electrolama/mcore-h616-breakout/README.md

# mcore-h616-breakout

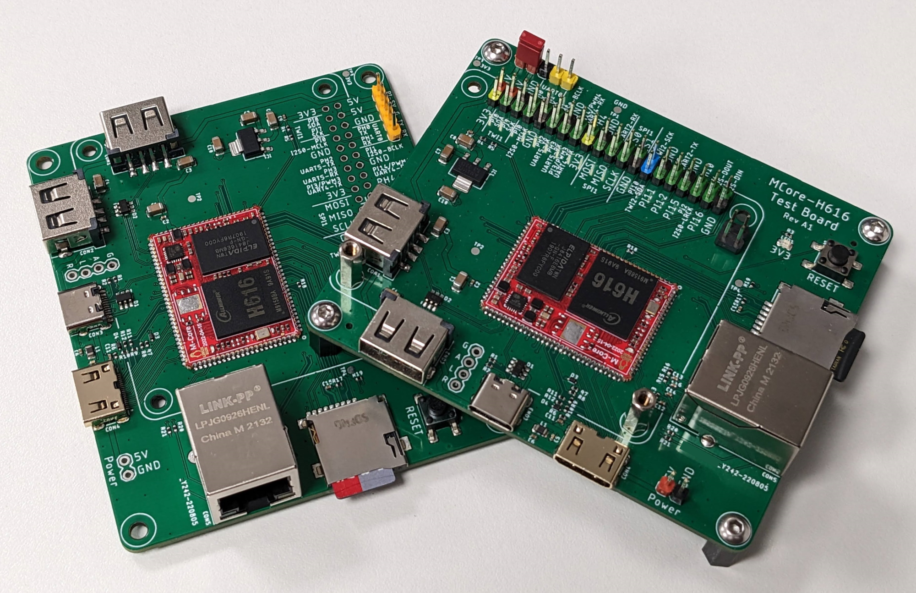
[picture p1: mcore-h616-test-board.jpg]
assembled mcore-h616-breakout boards


A breakout for the [Mango Pi MCore-H616](https://mangopi.org/mcoreh616) module.
