electrolama/mcore-h616-breakout/hardware/Revision A1/prod/mcore-h616-breakout-RevA1-PCBA.png

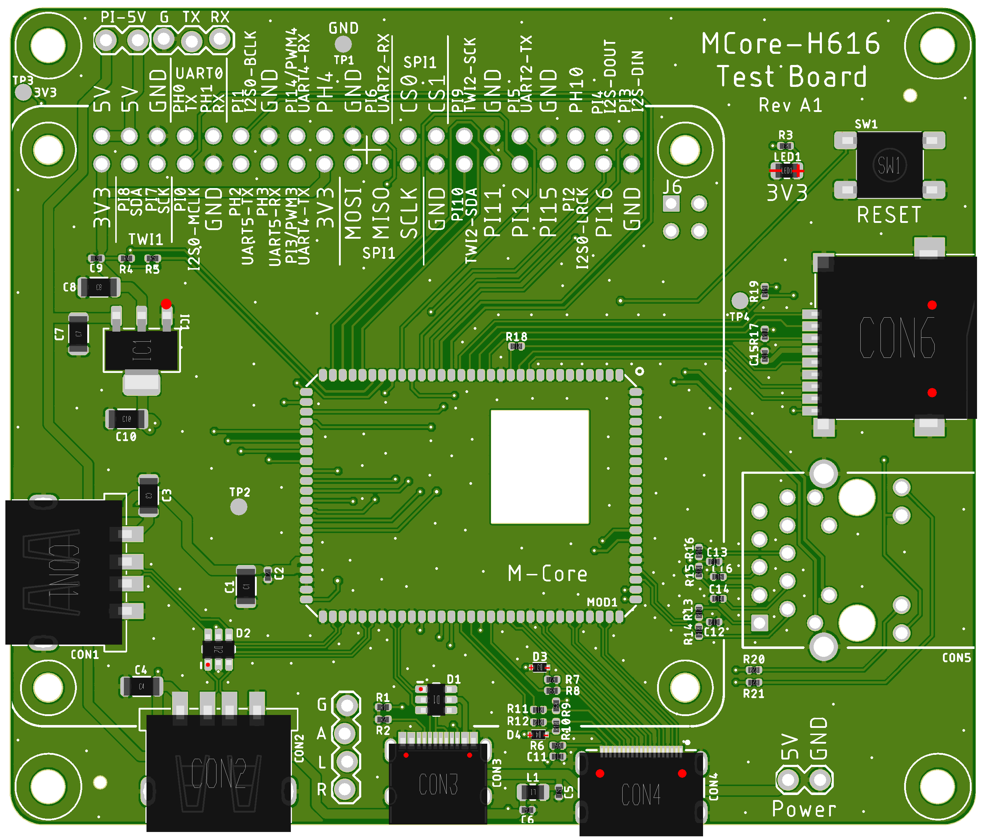
hardware/Revision A1/prod/mcore-h616-breakout-RevA1-PCBA.png
