electrolama/mcore-h616-breakout/reference/616core-back.png

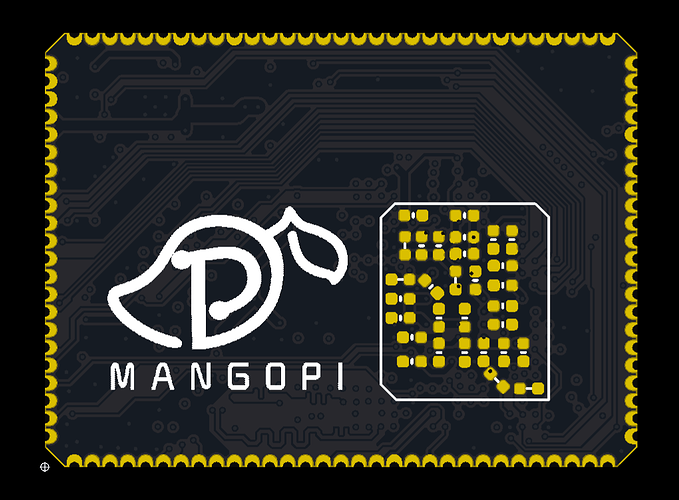
reference/616core-back.png
