electrolama/mcore-h616-breakout/reference/616core-front.png

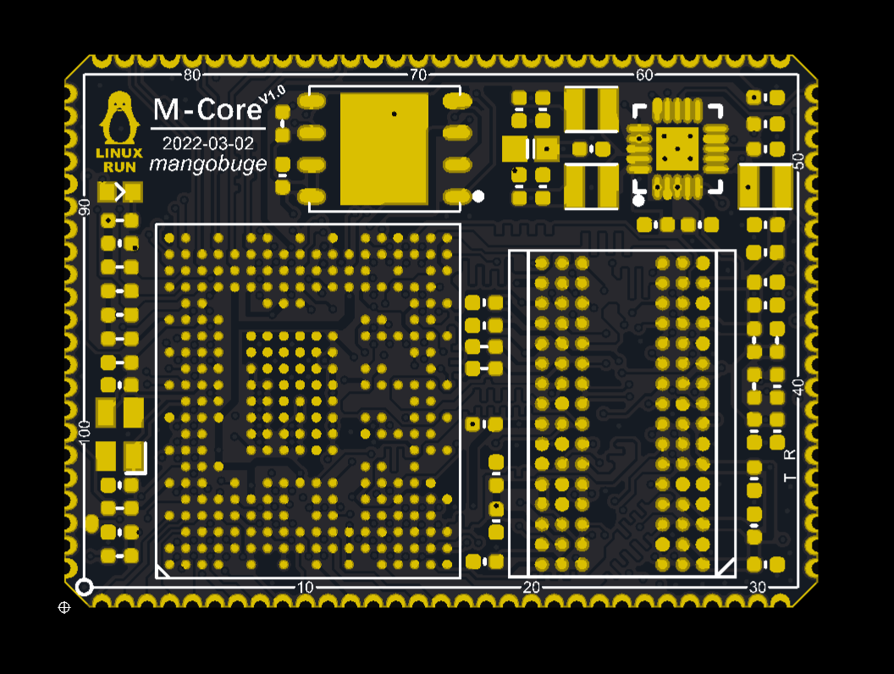
reference/616core-front.png
