electrolama/mcore-h616-breakout/reference/android-partitions.png

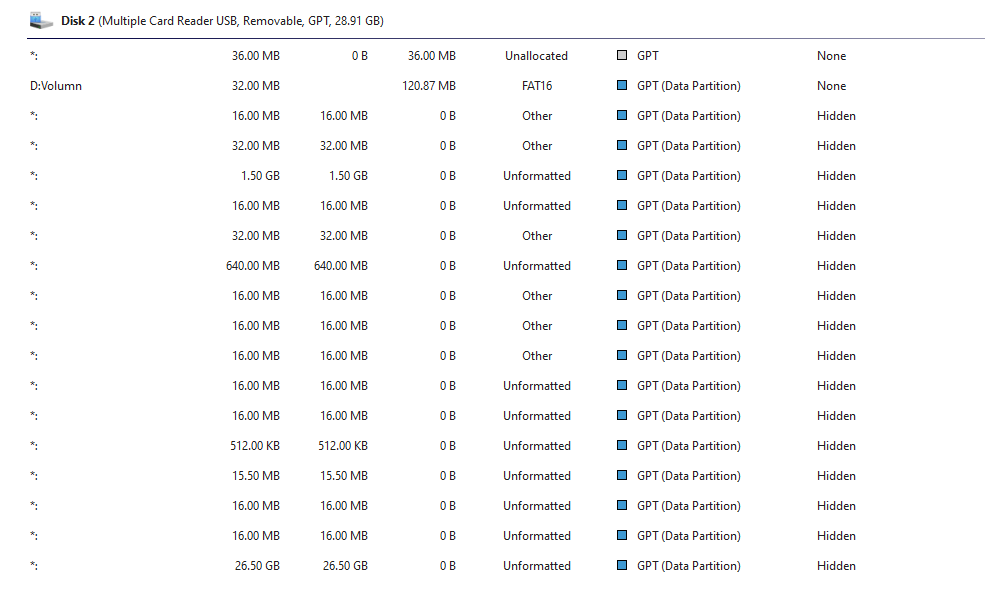
reference/android-partitions.png
