electrolama/mcore-h616-breakout/reference/android-phoenixcard.png

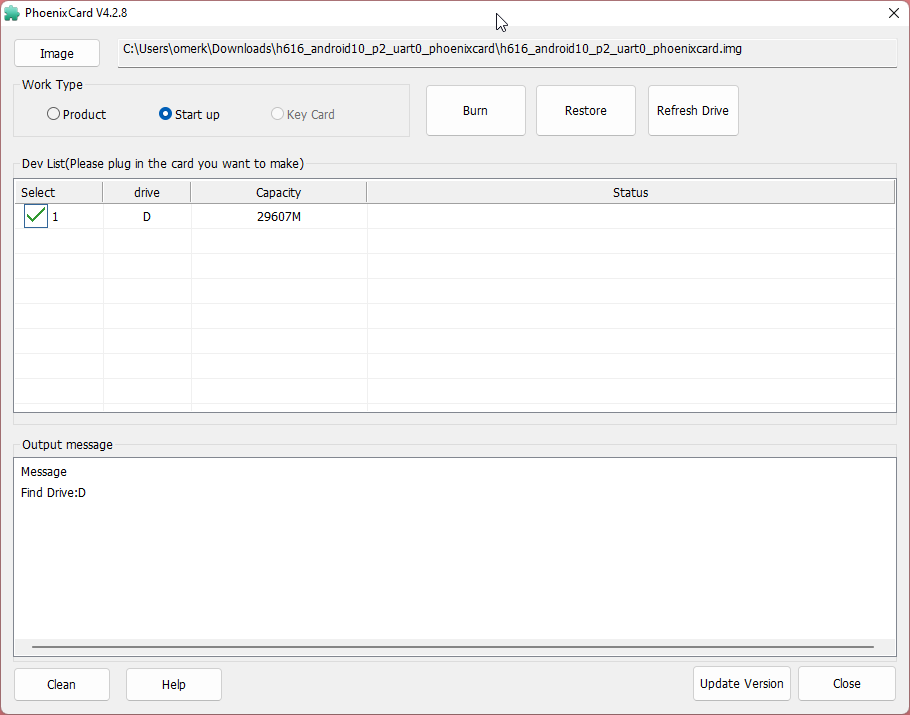
reference/android-phoenixcard.png
