electrolama/mcore-h616-breakout/reference/MQ-Quad-rpi40-pins.png

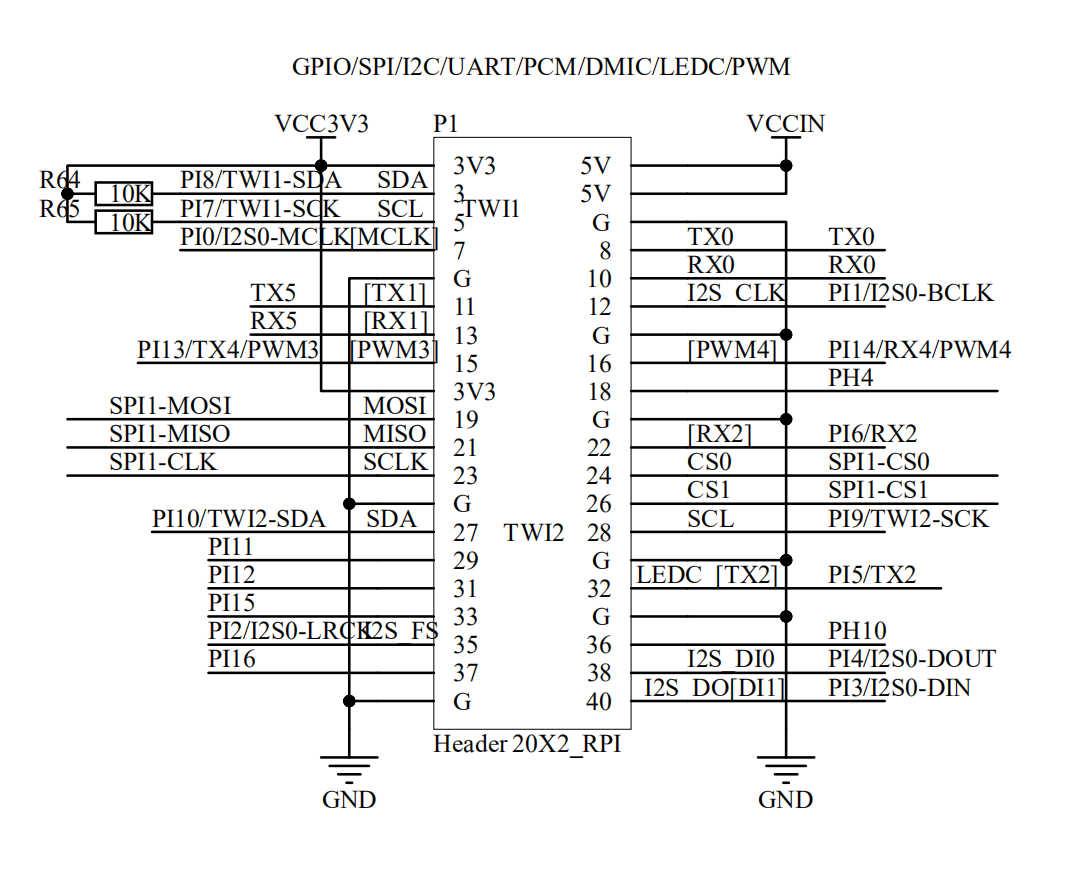
reference/MQ-Quad-rpi40-pins.png
