electrolama/mcore-h616-breakout/hardware/Revision A1/prod/mcore-h616-breakout-RevA1-BOM.xlsx

Comment | Designator | Footprint | JLCPCB Part # | Manufacturer | MPN | Qty
 | J3, J5 | 1X02_LOCK |  |  |  | 2
 | J2 | 1X03_LOCK |  |  |  | 1
 | J1 | 1X04_LOCK |  |  |  | 1
 | J6 | CON_2.54MM_TH_2X2 |  |  |  | 1
 | J4 | CON_2.54MM_TH_2X20 |  |  |  | 1
 | LED1 | _PKG_LED_0805 | C2296 |  |  | 1
 | CON1, CON2 | JING_912-121A2023S10100 | C42428 |  |  | 2
 | CON3 | USBC_C-31-M-12 | C165948 |  |  | 1
 | MOD1 | MCORE-H616_V1 |  |  |  | 1
100 | R3, R8, R11, R12, R18, R20, R21 | _PKG_R_0402 | C25076 |  |  | 7
100n | C2, C6, C9, C11, C12, C13, C14, C15, C16 | _PKG_C_0402 | C307331 |  |  | 9
10k | R4, R5, R17, R19 | _PKG_R_0402 | C25744 |  |  | 4
10n | C5 | _PKG_C_0402 | C15195 |  |  | 1
1k | R6 | _PKG_R_0402 | C11702 |  |  | 1
1k8 | R9, R10 | _PKG_R_0402 | C25871 |  |  | 2
27k 1% | R7 | _PKG_R_0402 | C25771 |  |  | 1
47u | C1, C3, C4, C7, C8, C10 | _PKG_C_1206 | C96123 |  |  | 6
49.9Ω | R13, R14, R15, R16 | _PKG_R_0402 | C25120 |  |  | 4
5k1 | R1, R2 | _PKG_R_0402 | C25905 |  |  | 2
C111196 - TF-15x15 | CON6 | TF/SHENZHEN-SPECIAL | C111196 |  |  | 1
C136421 - HDMI-519 | CON4 | 685119136923 | C136421 |  |  | 1
FB | L1 | _PKG_C_0805 | C75661 |  |  | 1
LD1117-3.3 | IC1 | _PKG_SOT223-4_TI-DCY4 | C6186 |  |  | 1
LPJG0926HENL | CON5 | LPJG0926HENL |  |  |  | 1
RB520S30T1G | D3, D4 | _PKG_SOD523 | C154821 |  |  | 2
SPNO | SW1 | GENERIC_SPNO_4P_6X6MM | C620316 |  |  | 1
SRV05-4-P-T7 | D1, D2 | SOT95P280X145-6N | C85364 |  |  | 2
