electrolama/mcore-h616-breakout/hardware/Revision A1/mcore-h616-breakout-RevA1-schematics.pdf

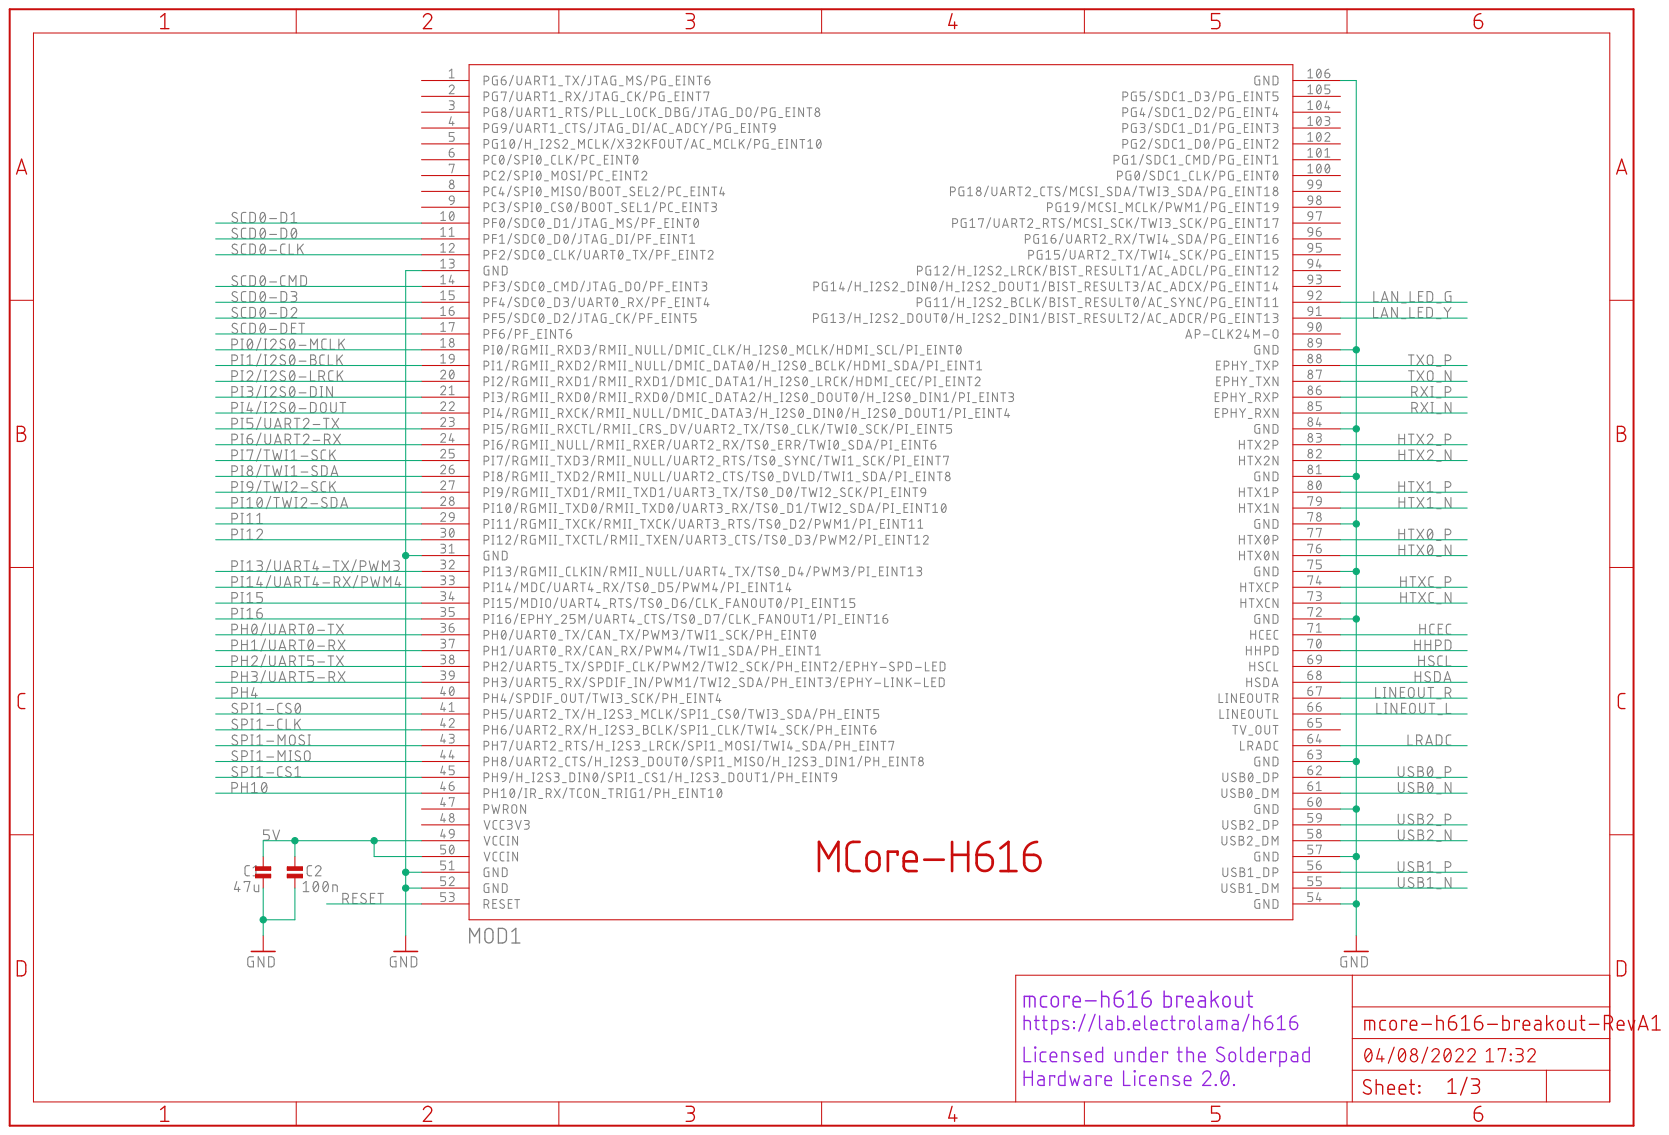
[picture p8: page 1]

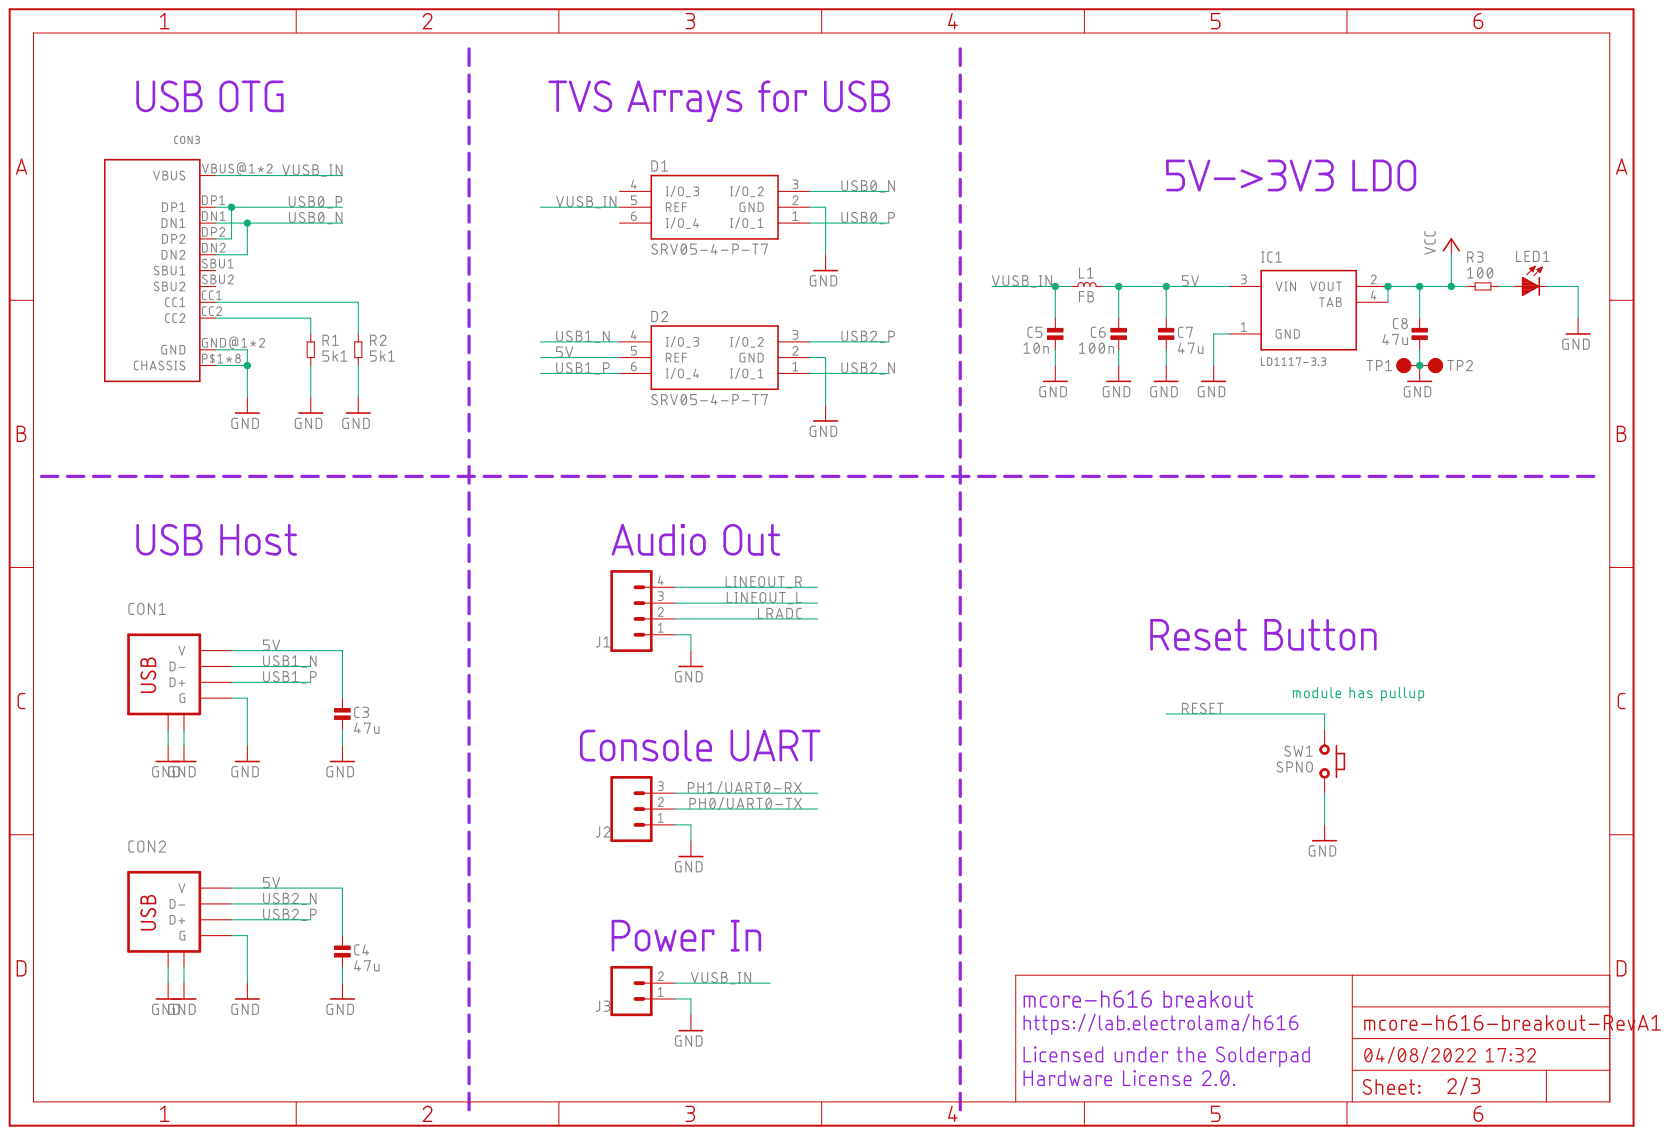
[picture p9: page 2]

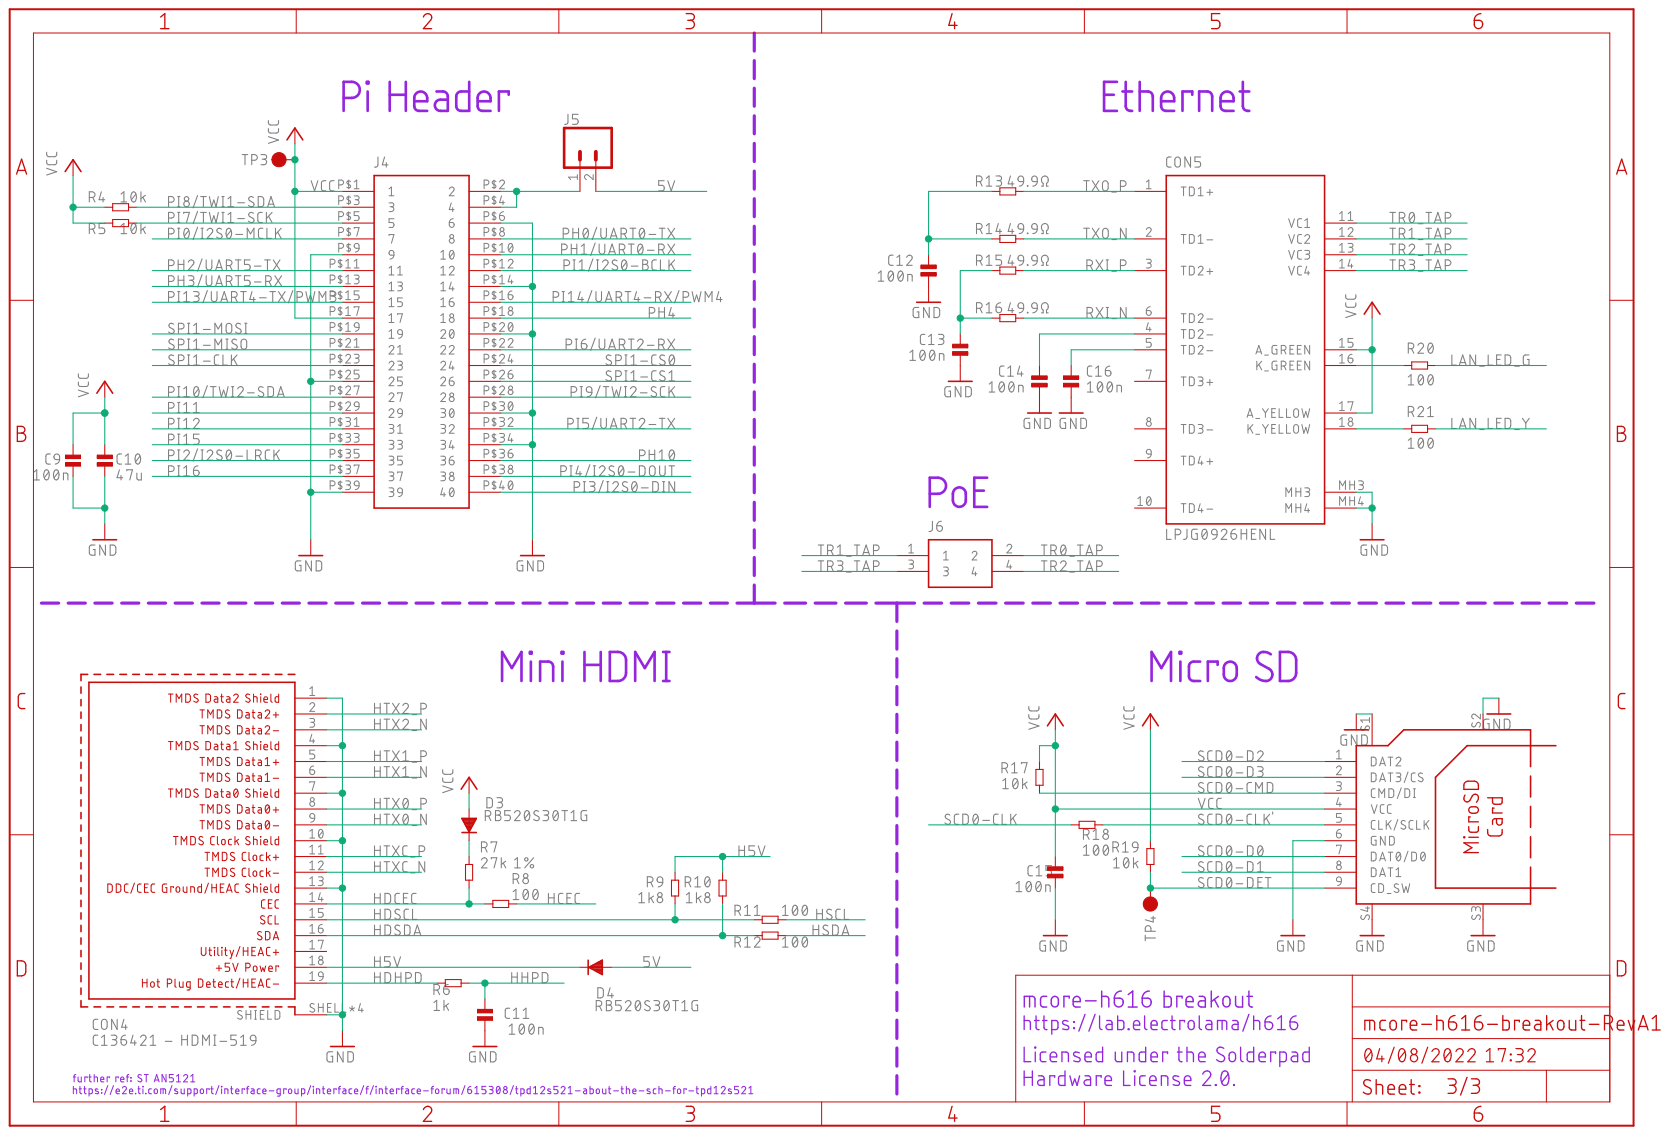
[picture p10: page 3]
