electrolama/mcore-h616-breakout/(list of files, drawings)

Other design files:
reference/616-demoboard/616-demo-PRJ.PrjPCB
reference/616-demoboard/D1-Periph.SchDoc
reference/616-demoboard/WIFI-BT.SchDoc
