electrolama/mcore-h616-breakout/hardware/Revision A1/mcore-h616-breakout-RevA1.brd

## EAGLE design hardware/Revision A1/mcore-h616-breakout-RevA1.brd (2022-08-04)

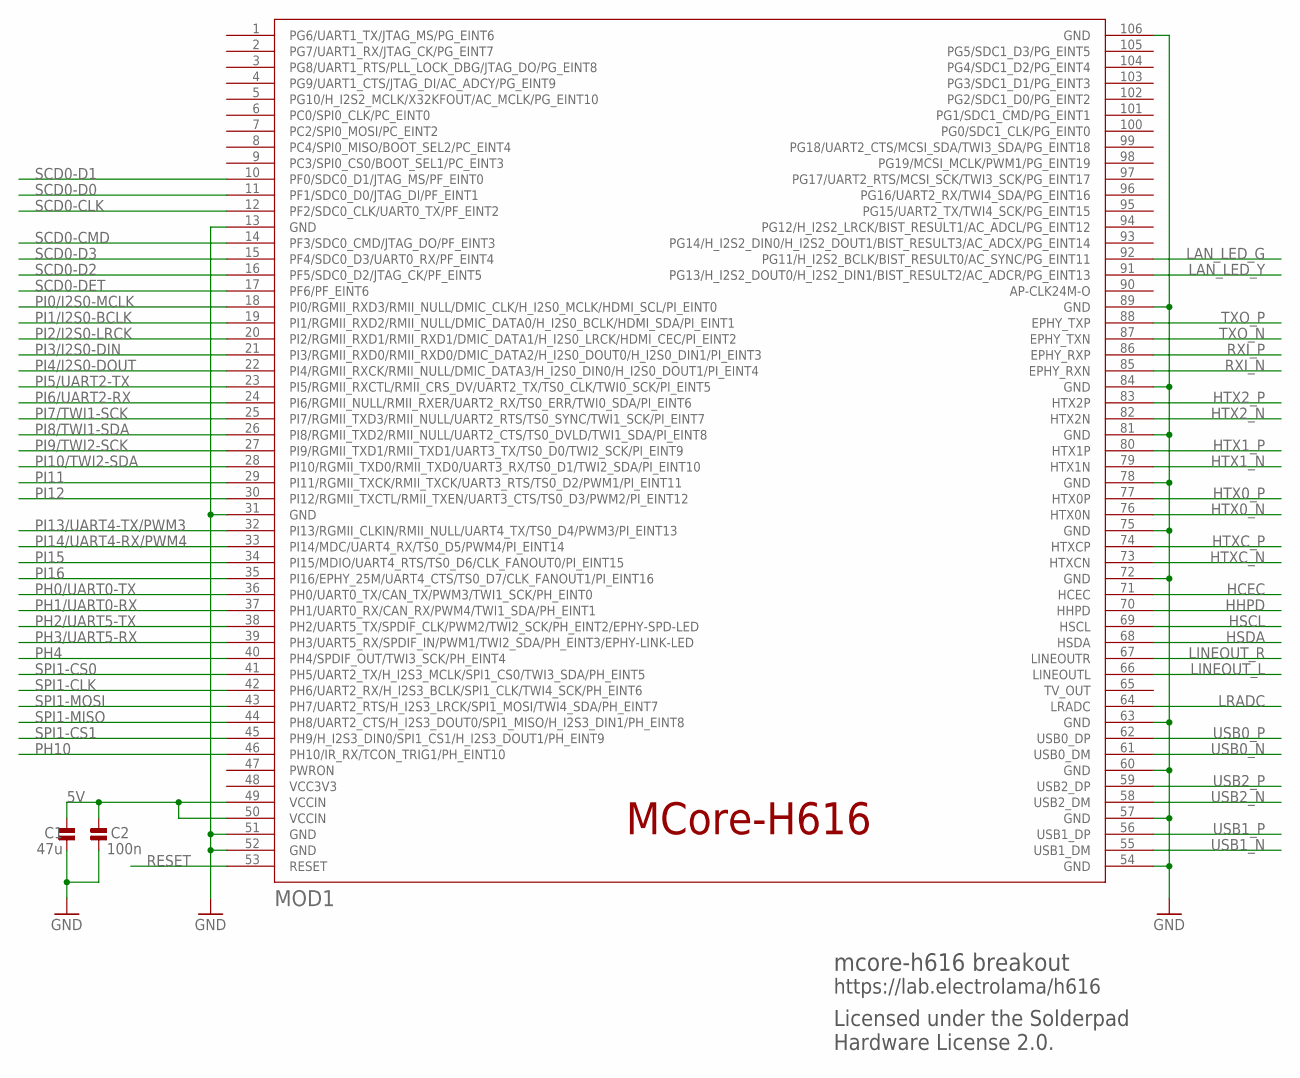
[picture p11: schematic mcore-h616-breakout-RevA1.sch, sheet 1]

Parts:
C1: 47u; _PKG_C_1206; JLCASSY C96123
C2: 100n; _PKG_C_0402; JLCASSY C307331
MOD1: WIDORA_MCORE-H616_V1; MCORE-H616_V1

Connections:
5V: C1.2, C2.2, MOD1.49 (VCCIN), MOD1.50 (VCCIN); also elsewhere on the board
GND: C1.1, C2.1, MOD1.13 (GND), MOD1.31 (GND), MOD1.51 (GND), MOD1.52 (GND), MOD1.54 (GND), MOD1.57 (GND), MOD1.60 (GND), MOD1.63 (GND), MOD1.72 (GND), MOD1.75 (GND), MOD1.78 (GND), MOD1.81 (GND), MOD1.84 (GND), MOD1.89 (GND), MOD1.106 (GND); also elsewhere on the board
HCEC: MOD1.71 (HCEC); also elsewhere on the board
HHPD: MOD1.70 (HHPD); also elsewhere on the board
HSCL: MOD1.69 (HSCL); also elsewhere on the board
HSDA: MOD1.68 (HSDA); also elsewhere on the board
HTX0_N: MOD1.76 (HTX0N); also elsewhere on the board
HTX0_P: MOD1.77 (HTX0P); also elsewhere on the board
HTX1_N: MOD1.79 (HTX1N); also elsewhere on the board
HTX1_P: MOD1.80 (HTX1P); also elsewhere on the board
HTX2_N: MOD1.82 (HTX2N); also elsewhere on the board
HTX2_P: MOD1.83 (HTX2P); also elsewhere on the board
HTXC_N: MOD1.73 (HTXCN); also elsewhere on the board
HTXC_P: MOD1.74 (HTXCP); also elsewhere on the board
LAN_LED_G: MOD1.92 (PG11/H_I2S2_BCLK/BIST_RESULT0/AC_SYNC/P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); also elsewhere on the board
LAN_LED_Y: MOD1.91 (PG13/H_I2S2_DOUT0/H_I2S2_DIN1/BIST_RESU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); also elsewhere on the board
LINEOUT_L: MOD1.66 (LINEOUTL); also elsewhere on the board
LINEOUT_R: MOD1.67 (LINEOUTR); also elsewhere on the board
LRADC: MOD1.64 (LRADC); also elsewhere on the board
PH0/UART0-TX: MOD1.36 (PH0/UART0_TX/CAN_TX/PWM3/TWI1_SCK/PH_EI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); also elsewhere on the board
PH1/UART0-RX: MOD1.37 (PH1/UART0_RX/CAN_RX/PWM4/TWI1_SDA/PH_EI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); also elsewhere on the board
PH2/UART5-TX: MOD1.38 (PH2/UART5_TX/SPDIF_CLK/PWM2/TWI2_SCK/PH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); also elsewhere on the board
PH3/UART5-RX: MOD1.39 (PH3/UART5_RX/SPDIF_IN/PWM1/TWI2_SDA/PH_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); also elsewhere on the board
PH4: MOD1.40 (PH4/SPDIF_OUT/TWI3_SCK/PH_EINT4); also elsewhere on the board
PH10: MOD1.46 (PH10/IR_RX/TCON_TRIG1/PH_EINT10); also elsewhere on the board
PI0/I2S0-MCLK: MOD1.18 (PI0/RGMII_RXD3/RMII_NULL/DMIC_CLK/H_I2S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); also elsewhere on the board
PI1/I2S0-BCLK: MOD1.19 (PI1/RGMII_RXD2/RMII_NULL/DMIC_DATA0/H_I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); also elsewhere on the board
PI2/I2S0-LRCK: MOD1.20 (PI2/RGMII_RXD1/RMII_RXD1/DMIC_DATA1/H_I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); also elsewhere on the board
PI3/I2S0-DIN: MOD1.21 (PI3/RGMII_RXD0/RMII_RXD0/DMIC_DATA2/H_I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); also elsewhere on the board
PI4/I2S0-DOUT: MOD1.22 (PI4/RGMII_RXCK/RMII_NULL/DMIC_DATA3/H_I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); also elsewhere on the board
PI5/UART2-TX: MOD1.23 (PI5/RGMII_RXCTL/RMII_CRS_DV/UART2_TX/TS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); also elsewhere on the board
PI6/UART2-RX: MOD1.24 (PI6/RGMII_NULL/RMII_RXER/UART2_RX/TS0_E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); also elsewhere on the board
PI7/TWI1-SCK: MOD1.25 (PI7/RGMII_TXD3/RMII_NULL/UART2_RTS/TS0_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); also elsewhere on the board
PI8/TWI1-SDA: MOD1.26 (PI8/RGMII_TXD2/RMII_NULL/UART2_CTS/TS0_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); also elsewhere on the board
PI9/TWI2-SCK: MOD1.27 (PI9/RGMII_TXD1/RMII_TXD1/UART3_TX/TS0_D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); also elsewhere on the board
PI10/TWI2-SDA: MOD1.28 (PI10/RGMII_TXD0/RMII_TXD0/UART3_RX/TS0_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); also elsewhere on the board
PI11: MOD1.29 (PI11/RGMII_TXCK/RMII_TXCK/UART3_RTS/TS0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); also elsewhere on the board
PI12: MOD1.30 (PI12/RGMII_TXCTL/RMII_TXEN/UART3_CTS/TS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); also elsewhere on the board
PI13/UART4-TX/PWM3: MOD1.32 (PI13/RGMII_CLKIN/RMII_NULL/UART4_TX/TS0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); also elsewhere on the board
PI14/UART4-RX/PWM4: MOD1.33 (PI14/MDC/UART4_RX/TS0_D5/PWM4/PI_EINT14); also elsewhere on the board
PI15: MOD1.34 (PI15/MDIO/UART4_RTS/TS0_D6/CLK_FANOUT0/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); also elsewhere on the board
PI16: MOD1.35 (PI16/EPHY_25M/UART4_CTS/TS0_D7/CLK_FANO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); also elsewhere on the board
RESET: MOD1.53 (RESET); also elsewhere on the board
RXI_N: MOD1.85 (EPHY_RXN); also elsewhere on the board
RXI_P: MOD1.86 (EPHY_RXP); also elsewhere on the board
SCD0-CLK: MOD1.12 (PF2/SDC0_CLK/UART0_TX/PF_EINT2); also elsewhere on the board
SCD0-CMD: MOD1.14 (PF3/SDC0_CMD/JTAG_DO/PF_EINT3); also elsewhere on the board
SCD0-D0: MOD1.11 (PF1/SDC0_D0/JTAG_DI/PF_EINT1); also elsewhere on the board
SCD0-D1: MOD1.10 (PF0/SDC0_D1/JTAG_MS/PF_EINT0); also elsewhere on the board
SCD0-D2: MOD1.16 (PF5/SDC0_D2/JTAG_CK/PF_EINT5); also elsewhere on the board
SCD0-D3: MOD1.15 (PF4/SDC0_D3/UART0_RX/PF_EINT4); also elsewhere on the board
SCD0-DET: MOD1.17 (PF6/PF_EINT6); also elsewhere on the board
SPI1-CLK: MOD1.42 (PH6/UART2_RX/H_I2S3_BCLK/SPI1_CLK/TWI4_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); also elsewhere on the board
SPI1-CS0: MOD1.41 (PH5/UART2_TX/H_I2S3_MCLK/SPI1_CS0/TWI3_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); also elsewhere on the board
SPI1-CS1: MOD1.45 (PH9/H_I2S3_DIN0/SPI1_CS1/H_I2S3_DOUT1/P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); also elsewhere on the board
SPI1-MISO: MOD1.44 (PH8/UART2_CTS/H_I2S3_DOUT0/SPI1_MISO/H_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); also elsewhere on the board
SPI1-MOSI: MOD1.43 (PH7/UART2_RTS/H_I2S3_LRCK/SPI1_MOSI/TWI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); also elsewhere on the board
TXO_N: MOD1.87 (EPHY_TXN); also elsewhere on the board
TXO_P: MOD1.88 (EPHY_TXP); also elsewhere on the board
USB0_N: MOD1.61 (USB0_DM); also elsewhere on the board
USB0_P: MOD1.62 (USB0_DP); also elsewhere on the board
USB1_N: MOD1.55 (USB1_DM); also elsewhere on the board
USB1_P: MOD1.56 (USB1_DP); also elsewhere on the board
USB2_N: MOD1.58 (USB2_DM); also elsewhere on the board
USB2_P: MOD1.59 (USB2_DP); also elsewhere on the board

Notes on the sheet:
mcore-h616 breakout
https://lab.electrolama/h616
Licensed under the Solderpad Hardware License 2.0.

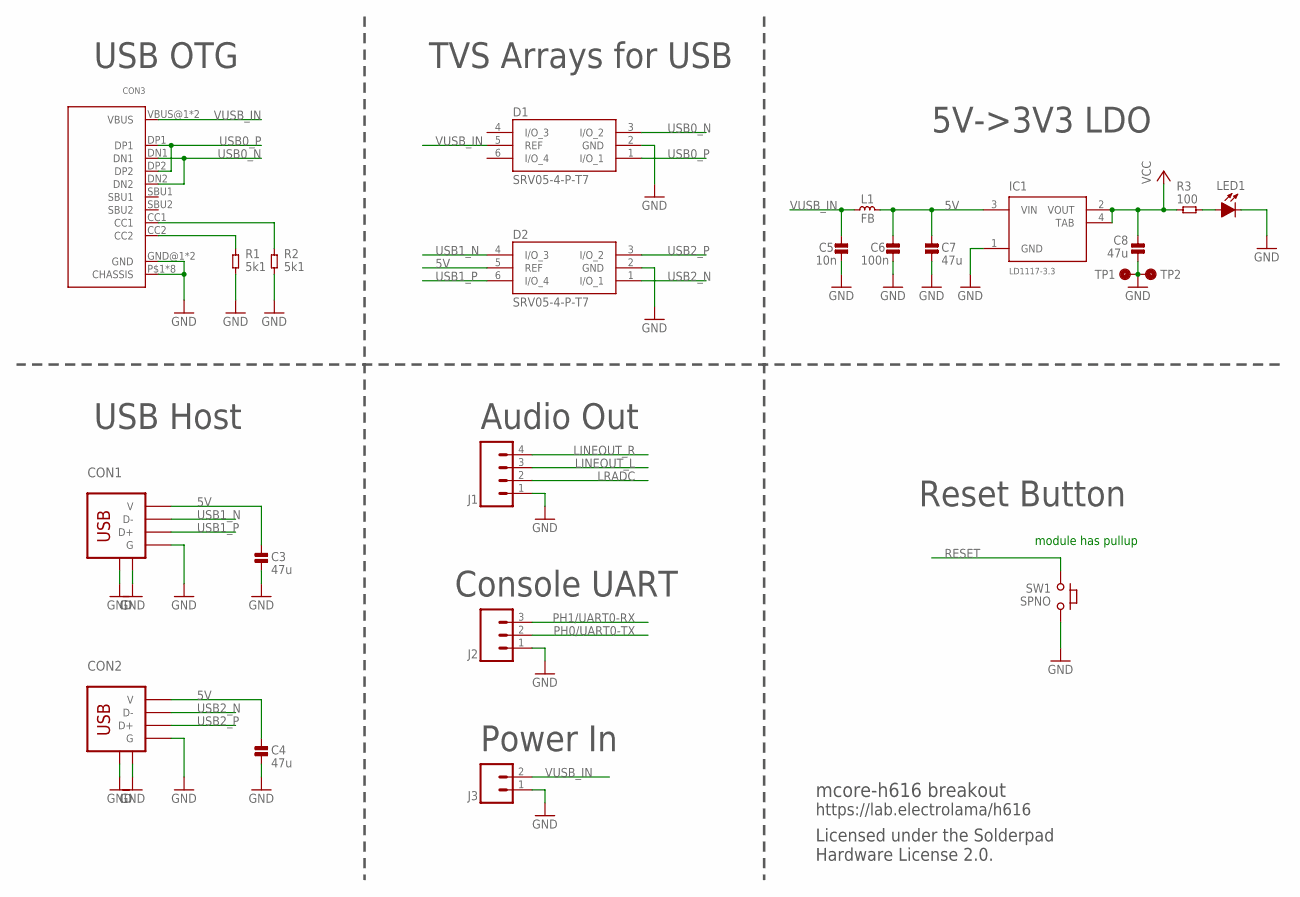
[picture p12: schematic mcore-h616-breakout-RevA1.sch, sheet 2]

Parts:
C3, C4, C7, C8: 47u; _PKG_C_1206; JLCASSY C96123
C5: 10n; _PKG_C_0402; JLCASSY C15195
C6: 100n; _PKG_C_0402; JLCASSY C307331
CON1, CON2: USB-A-FEMALE-JING-912-121A2023S10100; JING_912-121A2023S10100; JLCASSY C42428
CON3: USBC_USB-C-12; USBC_C-31-M-12; JLCASSY C165948
D1, D2: SRV05-4-P-T7; SOT95P280X145-6N; JLCASSY C85364
IC1: LD1117-3.3; _PKG_SOT223-4_TI-DCY4; JLCASSY C6186
J1: CONN_04LOCK; 1X04_LOCK
J2: CONN_03LOCK; 1X03_LOCK
J3: CONN_02LOCK; 1X02_LOCK
L1: FB; _PKG_C_0805; JLCASSY C75661
LED1: LED-0805; _PKG_LED_0805; JLCASSY C2296
R1, R2: 5k1; _PKG_R_0402; JLCASSY C25905
R3: 100; _PKG_R_0402; JLCASSY C25076
SW1: SPNO; GENERIC_SPNO_4P_6X6MM; JLCASSY C620316
TP1, TP2: TP; TP_DOT_1.5X1.5MM

Connections:
5V: C3.2, C4.2, C6.2, C7.2, CON1.VBUS (V), CON2.VBUS (V), D2.5 (REF), IC1.3 (VIN), L1.2; also elsewhere on the board
GND: C3.1, C4.1, C5.1, C6.1, C7.1, C8.1, CON1.GND (G), CON1.P$5 (SHIELD1), CON1.P$6 (SHIELD2), CON2.GND (G), CON2.P$5 (SHIELD1), CON2.P$6 (SHIELD2), CON3.GND@1 (GND), CON3.GND@2 (GND), CON3.P$1 (CHASSIS), CON3.P$2 (CHASSIS), CON3.P$3 (CHASSIS), CON3.P$4 (CHASSIS), CON3.P$5 (CHASSIS), CON3.P$6 (CHASSIS), CON3.P$7 (CHASSIS), CON3.P$8 (CHASSIS), D1.2 (GND), D2.2 (GND), IC1.1 (GND), J1.1, J2.1, J3.1, LED1.C, R1.1, R2.1, SW1.P$3 (2), SW1.P$4 (2), TP1.TP, TP2.TP; also elsewhere on the board
LINEOUT_L: J1.3; also elsewhere on the board
LINEOUT_R: J1.4; also elsewhere on the board
LRADC: J1.2; also elsewhere on the board
unnamed: LED1.A, R3.1
unnamed: CON3.CC1, R2.2
unnamed: CON3.CC2, R1.2
PH0/UART0-TX: J2.2; also elsewhere on the board
PH1/UART0-RX: J2.3; also elsewhere on the board
RESET: SW1.P$1 (1), SW1.P$2 (1); also elsewhere on the board
USB0_N: CON3.DN1, CON3.DN2, D1.3 (I/O_2); also elsewhere on the board
USB0_P: CON3.DP1, CON3.DP2, D1.1 (I/O_1); also elsewhere on the board
USB1_N: CON1.DM (D-), D2.4 (I/O_3); also elsewhere on the board
USB1_P: CON1.DP (D+), D2.6 (I/O_4); also elsewhere on the board
USB2_N: CON2.DM (D-), D2.1 (I/O_1); also elsewhere on the board
USB2_P: CON2.DP (D+), D2.3 (I/O_2); also elsewhere on the board
VCC: C8.2, IC1.2 (VOUT), IC1.4 (TAB), R3.2; also elsewhere on the board
VUSB_IN: C5.2, CON3.VBUS@1 (VBUS), CON3.VBUS@2 (VBUS), D1.5 (REF), J3.2, L1.1

Notes on the sheet:
module has pullup
USB OTG
TVS Arrays for USB
USB Host
Audio Out
Console UART
Power In
Reset Button
5V->3V3 LDO
mcore-h616 breakout
https://lab.electrolama/h616
Licensed under the Solderpad Hardware License 2.0.

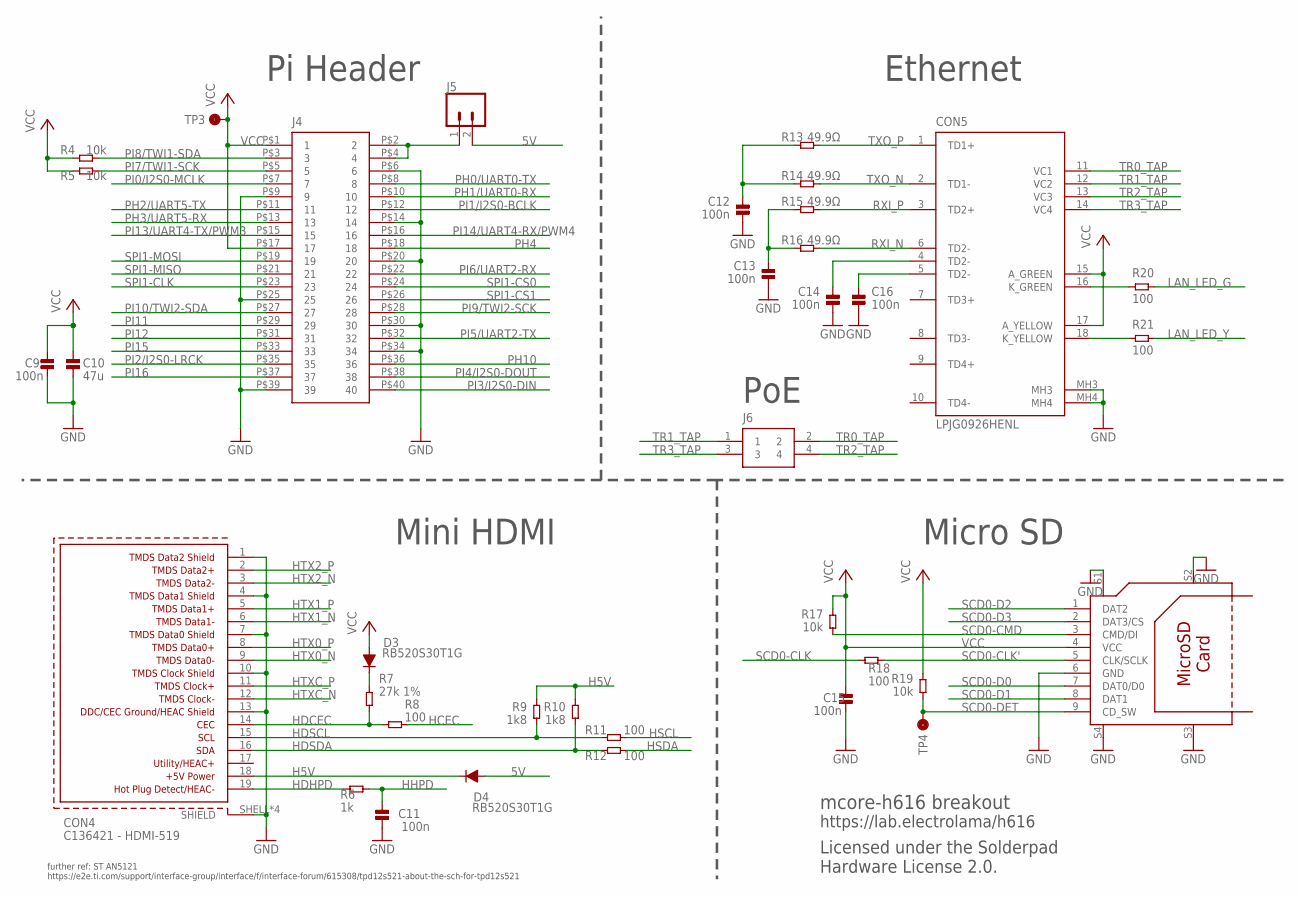
[picture p13: schematic mcore-h616-breakout-RevA1.sch, sheet 3]

Parts:
C9, C11, C12, C13, C14, C15, C16: 100n; _PKG_C_0402; JLCASSY C307331
C10: 47u; _PKG_C_1206; JLCASSY C96123
CON4: C136421 - HDMI-519; 685119136923; JLCASSY C136421
CON5: LPJG0926HENL
CON6: C111196 - TF-15x15; TF/SHENZHEN-SPECIAL; JLCASSY C111196
D3, D4: RB520S30T1G; _PKG_SOD523; JLCASSY C154821
J4: CON_2.54MM_TH_2X20
J5: CONN_02LOCK; 1X02_LOCK
J6: CON_2.54MM_TH_2X2
R4, R5, R17, R19: 10k; _PKG_R_0402; JLCASSY C25744
R6: 1k; _PKG_R_0402; JLCASSY C11702
R7: 27k 1%; _PKG_R_0402; JLCASSY C25771
R8, R11, R12, R18, R20, R21: 100; _PKG_R_0402; JLCASSY C25076
R9, R10: 1k8; _PKG_R_0402; JLCASSY C25871
R13, R14, R15, R16: 49.9Ω; _PKG_R_0402; JLCASSY C25120
TP3, TP4: TP; TP_DOT_1.5X1.5MM

Connections:
5V: D4.2 (A), J5.2; also elsewhere on the board
GND: C9.1, C10.1, C11.1, C12.1, C13.1, C14.1, C15.1, C16.1, CON4.1 (TMDSDATA2SHIELD), CON4.4 (TMDSDATA1SHIELD), CON4.7 (TMDSDATA0SHIELD), CON4.10 (TMDSCLOCKSHIELD), CON4.13 (DDC/CECGROUND/HEACSHIELD), CON4.SHELL (SHIELD), CON4.SHELL1 (SHIELD), CON4.SHELL2 (SHIELD), CON4.SHELL3 (SHIELD), CON5.MH3, CON5.MH4, CON6.6 (GND), CON6.S1, CON6.S2, CON6.S3, CON6.S4, J4.P$6 (6), J4.P$9 (9), J4.P$14 (14), J4.P$20 (20), J4.P$25 (25), J4.P$30 (30), J4.P$34 (34), J4.P$39 (39); also elsewhere on the board
H5V: CON4.18 (+5VPOWER), D4.1 (C), R9.1, R10.1
HCEC: R8.2; also elsewhere on the board
HDCEC: CON4.14 (CEC), R7.1, R8.1
HDHPD: CON4.19 (HOTPLUGDETECT/HEAC-), R6.1
HDSCL: CON4.15 (SCL), R9.2, R11.1
HDSDA: CON4.16 (SDA), R10.2, R12.1
HHPD: C11.2, R6.2; also elsewhere on the board
HSCL: R11.2; also elsewhere on the board
HSDA: R12.2; also elsewhere on the board
HTX0_N: CON4.9 (TMDSDATA0-); also elsewhere on the board
HTX0_P: CON4.8 (TMDSDATA0+); also elsewhere on the board
HTX1_N: CON4.6 (TMDSDATA1-); also elsewhere on the board
HTX1_P: CON4.5 (TMDSDATA1+); also elsewhere on the board
HTX2_N: CON4.3 (TMDSDATA2-); also elsewhere on the board
HTX2_P: CON4.2 (TMDSDATA2+); also elsewhere on the board
HTXC_N: CON4.12 (TMDSCLOCK-); also elsewhere on the board
HTXC_P: CON4.11 (TMDSCLOCK+); also elsewhere on the board
LAN_LED_G: R20.2; also elsewhere on the board
LAN_LED_Y: R21.2; also elsewhere on the board
unnamed: CON5.16 (K_GREEN), R20.1
unnamed: C14.2, CON5.4 (TD2-)
unnamed: C16.2, CON5.5 (TD2-)
unnamed: J4.P$2 (2), J4.P$4 (4), J5.1
unnamed: CON5.18 (K_YELLOW), R21.1
unnamed: D3.1 (C), R7.2
unnamed: C12.2, R13.1, R14.1
unnamed: C13.2, R15.1, R16.1
PH0/UART0-TX: J4.P$8 (8); also elsewhere on the board
PH1/UART0-RX: J4.P$10 (10); also elsewhere on the board
PH2/UART5-TX: J4.P$11 (11); also elsewhere on the board
PH3/UART5-RX: J4.P$13 (13); also elsewhere on the board
PH4: J4.P$18 (18); also elsewhere on the board
PH10: J4.P$36 (36); also elsewhere on the board
PI0/I2S0-MCLK: J4.P$7 (7); also elsewhere on the board
PI1/I2S0-BCLK: J4.P$12 (12); also elsewhere on the board
PI2/I2S0-LRCK: J4.P$35 (35); also elsewhere on the board
PI3/I2S0-DIN: J4.P$40 (40); also elsewhere on the board
PI4/I2S0-DOUT: J4.P$38 (38); also elsewhere on the board
PI5/UART2-TX: J4.P$32 (32); also elsewhere on the board
PI6/UART2-RX: J4.P$22 (22); also elsewhere on the board
PI7/TWI1-SCK: J4.P$5 (5), R5.2; also elsewhere on the board
PI8/TWI1-SDA: J4.P$3 (3), R4.2; also elsewhere on the board
PI9/TWI2-SCK: J4.P$28 (28); also elsewhere on the board
PI10/TWI2-SDA: J4.P$27 (27); also elsewhere on the board
PI11: J4.P$29 (29); also elsewhere on the board
PI12: J4.P$31 (31); also elsewhere on the board
PI13/UART4-TX/PWM3: J4.P$15 (15); also elsewhere on the board
PI14/UART4-RX/PWM4: J4.P$16 (16); also elsewhere on the board
PI15: J4.P$33 (33); also elsewhere on the board
PI16: J4.P$37 (37); also elsewhere on the board
RXI_N: CON5.6 (TD2-), R16.2; also elsewhere on the board
RXI_P: CON5.3 (TD2+), R15.2; also elsewhere on the board
SCD0-CLK: R18.2; also elsewhere on the board
SCD0-CLK': CON6.5 (CLK/SCLK), R18.1
SCD0-CMD: CON6.3 (CMD/DI), R17.1; also elsewhere on the board
SCD0-D0: CON6.7 (DAT0/D0); also elsewhere on the board
SCD0-D1: CON6.8 (DAT1); also elsewhere on the board
SCD0-D2: CON6.1 (DAT2); also elsewhere on the board
SCD0-D3: CON6.2 (DAT3/CS); also elsewhere on the board
SCD0-DET: CON6.9 (CD_SW), R19.1, TP4.TP; also elsewhere on the board
SPI1-CLK: J4.P$23 (23); also elsewhere on the board
SPI1-CS0: J4.P$24 (24); also elsewhere on the board
SPI1-CS1: J4.P$26 (26); also elsewhere on the board
SPI1-MISO: J4.P$21 (21); also elsewhere on the board
SPI1-MOSI: J4.P$19 (19); also elsewhere on the board
TR0_TAP: CON5.11 (VC1), J6.2
TR1_TAP: CON5.12 (VC2), J6.1
TR2_TAP: CON5.13 (VC3), J6.4
TR3_TAP: CON5.14 (VC4), J6.3
TXO_N: CON5.2 (TD1-), R14.2; also elsewhere on the board
TXO_P: CON5.1 (TD1+), R13.2; also elsewhere on the board
VCC: C9.2, C10.2, C15.2, CON5.15 (A_GREEN), CON5.17 (A_YELLOW), CON6.4 (VCC), D3.2 (A), J4.P$1 (1), J4.P$17 (17), R4.1, R5.1, R17.2, R19.2, TP3.TP; also elsewhere on the board

Notes on the sheet:
Mini HDMI
Pi Header
Ethernet
PoE
Micro SD
mcore-h616 breakout
https://lab.electrolama/h616
Licensed under the Solderpad Hardware License 2.0.
further ref: ST AN5121 https://e2e.ti.com/support/interface-group/interface/f/interface-forum/615308/tpd12s521-about-the-sch-for-tpd12s521

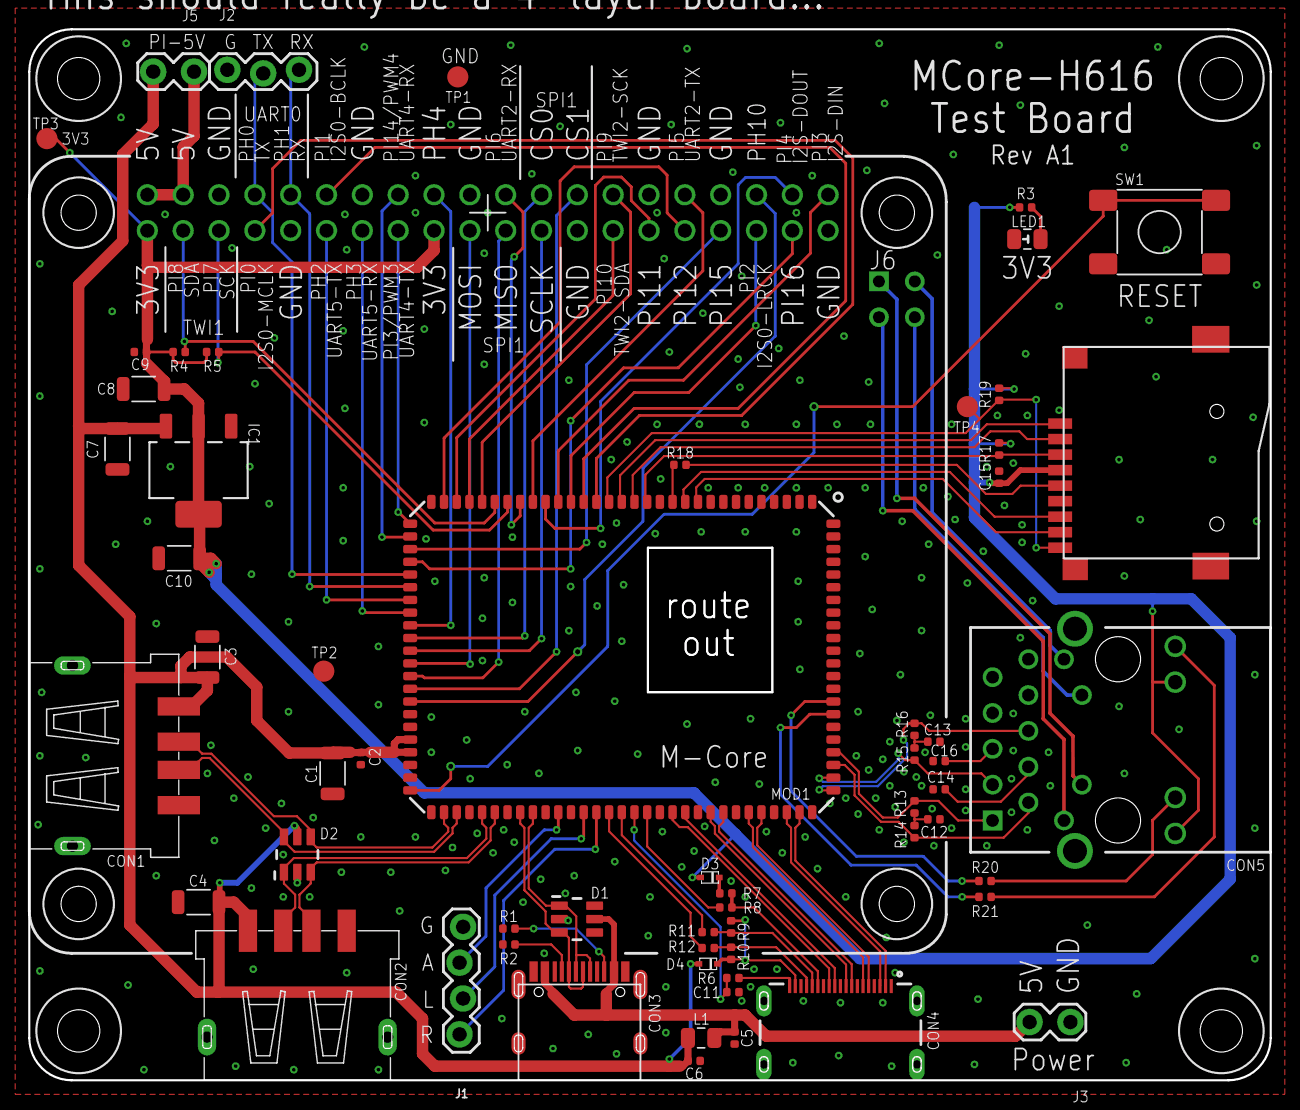
[picture p14: board mcore-h616-breakout-RevA1.brd from above]

Board: 2 copper layers, 88.0 x 74.5 mm, 62 parts (0 on the bottom side), 88 nets.
