electrolama/mcore-h616-breakout/(commit log)

2022-08-01 initial check-in for RevA1
    [mcore-h616-breakout-RevA1.brd, mcore-h616-breakout-RevA1.sch]
2022-08-01 add reference material
    [616-demo-PRJ.PrjPCB, D1-Periph.SchDoc, WIFI-BT.SchDoc]
2022-08-04 clean-up and mfg release for rev A1
    [mcore-h616-breakout-RevA1-BOM.xlsx, mcore-h616-breakout-RevA1.brd, mcore-h616-breakout-RevA1.sch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]
2022-08-04 proper pdf export of schematics
2022-12-14 add photo of assembled boards
