electrolama/mcore-h616-breakout/(notices)

Notices in the files:
parts and their libraries:
Wurth_Connectors_WR-HDMI: Copyright: Würth Elektronik
SparkFun-Connectors: Licensing: Creative Commons ShareAlike 4.0 International - https://creativecommons.org/licenses/by-sa/4.0
